celeron55/ipdm56/ipdmhw1.1/README.md

iPDM56 v1.1
===========

iPDM56 v1.1 fixing the board
----------------------------

There is one bug on the v1.1 board. This is what you need to do to get it
working:
- Replace R97 with a 1k resistor. Originally it is a 10k resistor. To save some
  effort, you can solder the 1k resistor on top of the 10k resistor, putting it
  in parallel. The package size is 0603. A through hole resistor will fit fine.
    - If this fix is not made, the CAN controllers will not work.

iPDM56 v1.1 flashing
--------------------

Bootloader:
- Install Arduino.
- Select Arduino Uno as the board in Arduino.
- Connect an ISP programmer like USBasp to the ISP header. GND is closer to board edge.
- Select the ISP programmer in Arduino's Tools menu.
- Use Arduino's "Burn bootloader" option in the Tools menu.

Uploading program:
- Select Arduino Uno as the board in Arduino.
- Plug in a USB 2.0 micro B cable to the USB connector, OR
- Cut your most hated USB cable in half and connect it to the 56-pin connector pins (according to the iPDM56 connector pinout):
	- 10: USB 5V  (red)
	- 12: USB D-  (white)
	- 14: USB D+  (green)
	- 16: USB GND (black)
