celeron55/ipdm56/ipdmhw1.0/flashing/iPDM56_v1.0_flashing_065.jpg

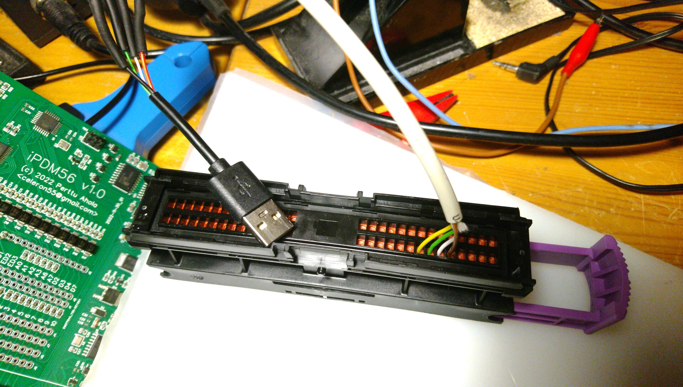
ipdmhw1.0/flashing/iPDM56_v1.0_flashing_065.jpg
