celeron55/ipdm56/ipdmhw1.0/iPDM56_v1.0_connector_photo_light.jpg

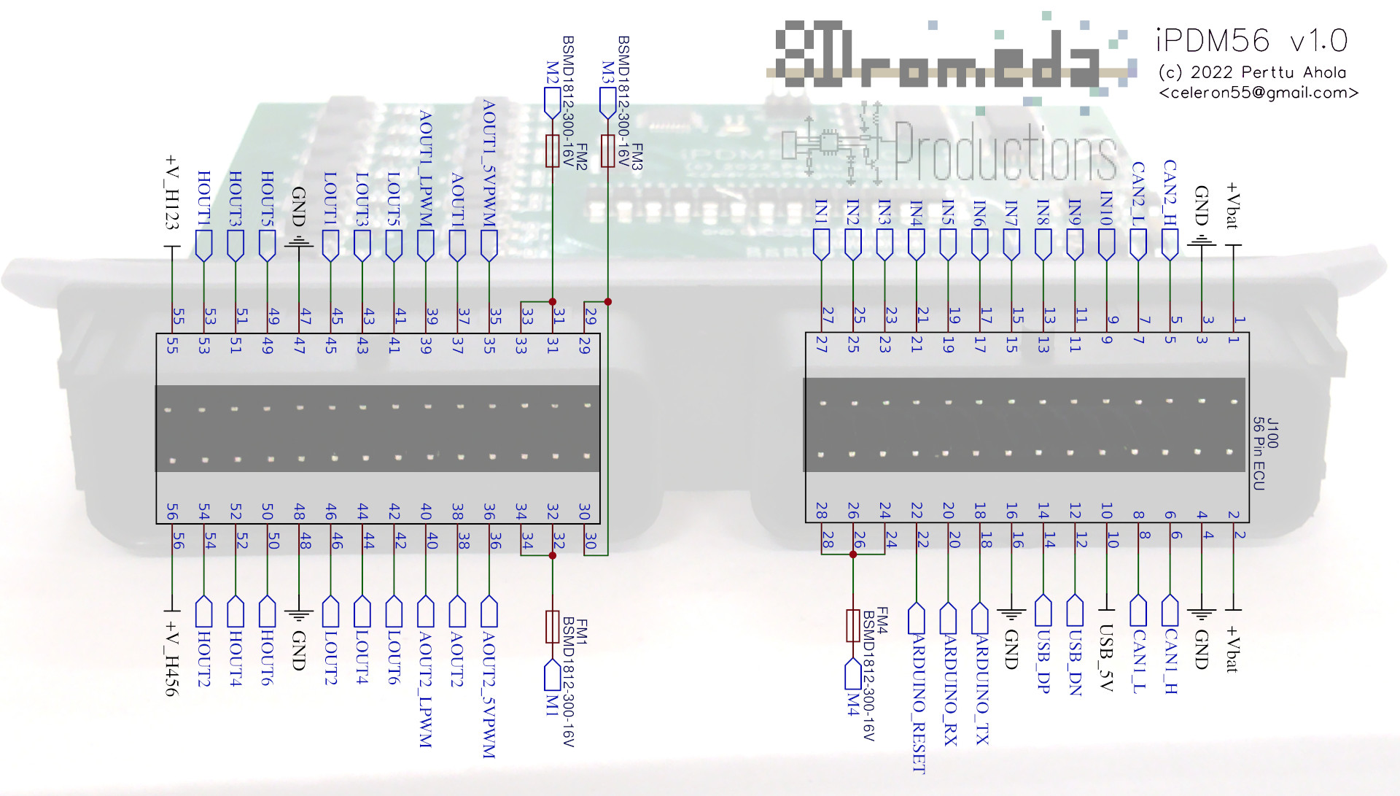
ipdmhw1.0/iPDM56_v1.0_connector_photo_light.jpg
