celeron55/ipdm56/ipdmhw1.1/iPDM56_v1.1_connector_photo_light.jpg

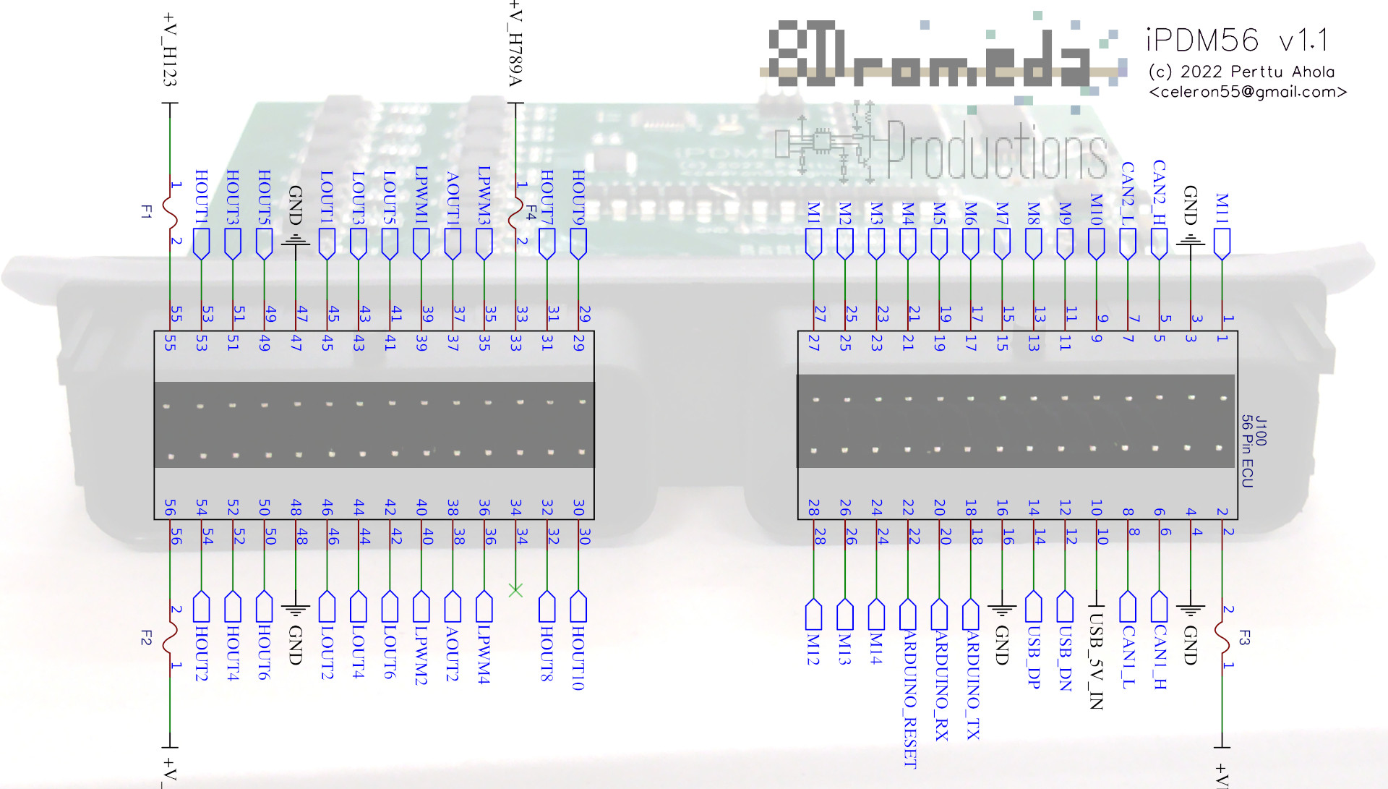
ipdmhw1.1/iPDM56_v1.1_connector_photo_light.jpg
