celeron55/ipdm56/ipdmhw1.1/ipdm56_v1.1_pcb_layers.png

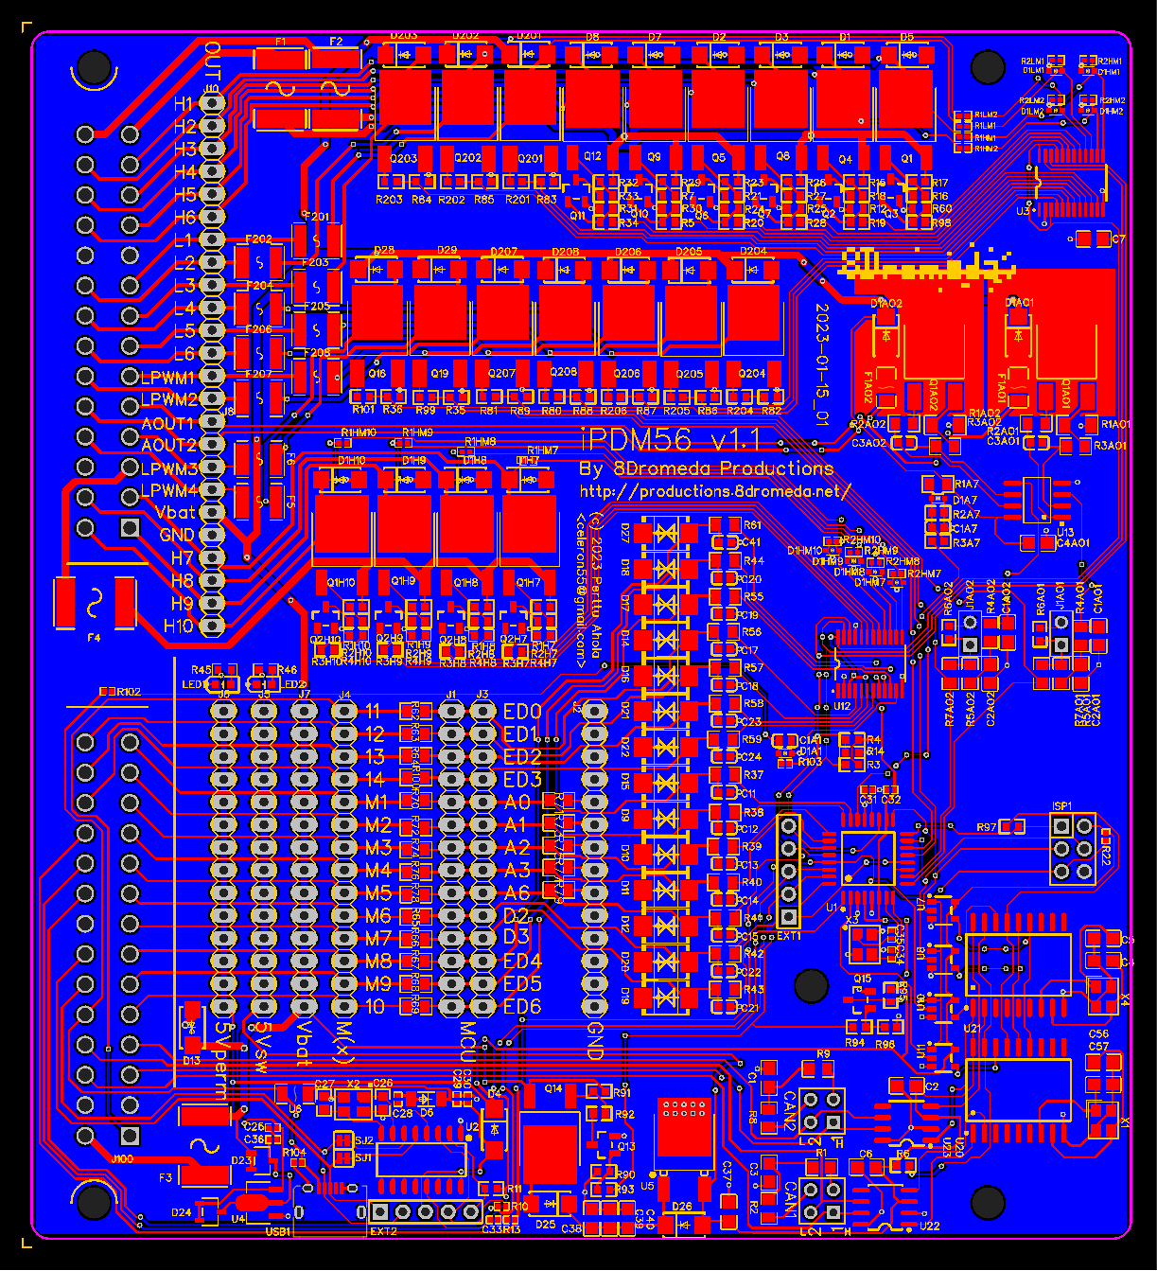
ipdmhw1.1/ipdm56_v1.1_pcb_layers.png
