celeron55/ipdm56/ipdmhw1.1/iPDM56_v1.1_PCB_render_backside.png

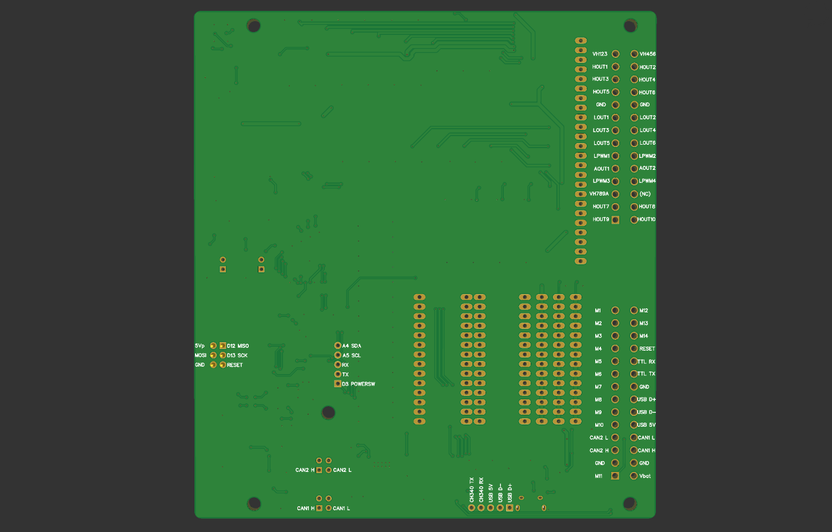
ipdmhw1.1/iPDM56_v1.1_PCB_render_backside.png
