celeron55/ipdm56/ipdmhw2.0/iPDM56v2.0_connector_pinout_light_upright.png

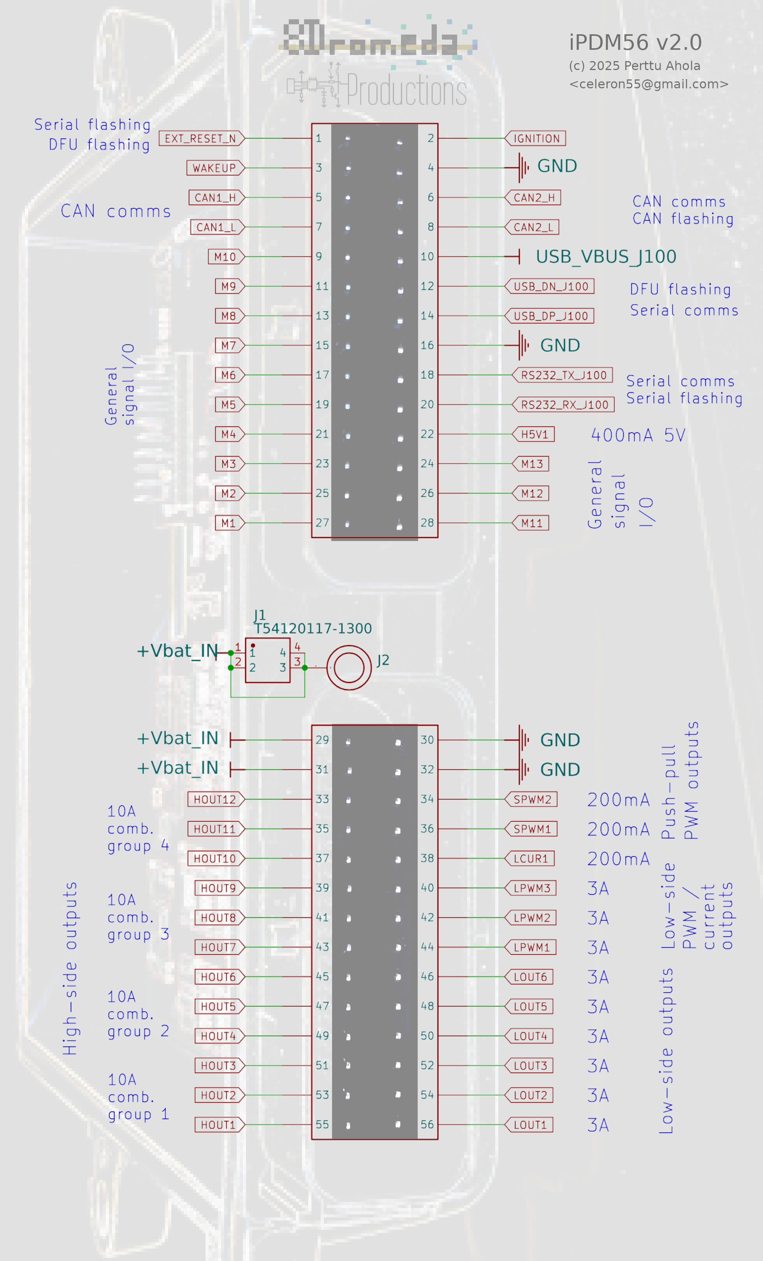
ipdmhw2.0/iPDM56v2.0_connector_pinout_light_upright.png
