celeron55/ipdm56/ipdmhw2.0/iPDM56v2.0_photo_in_enclosure.jpg

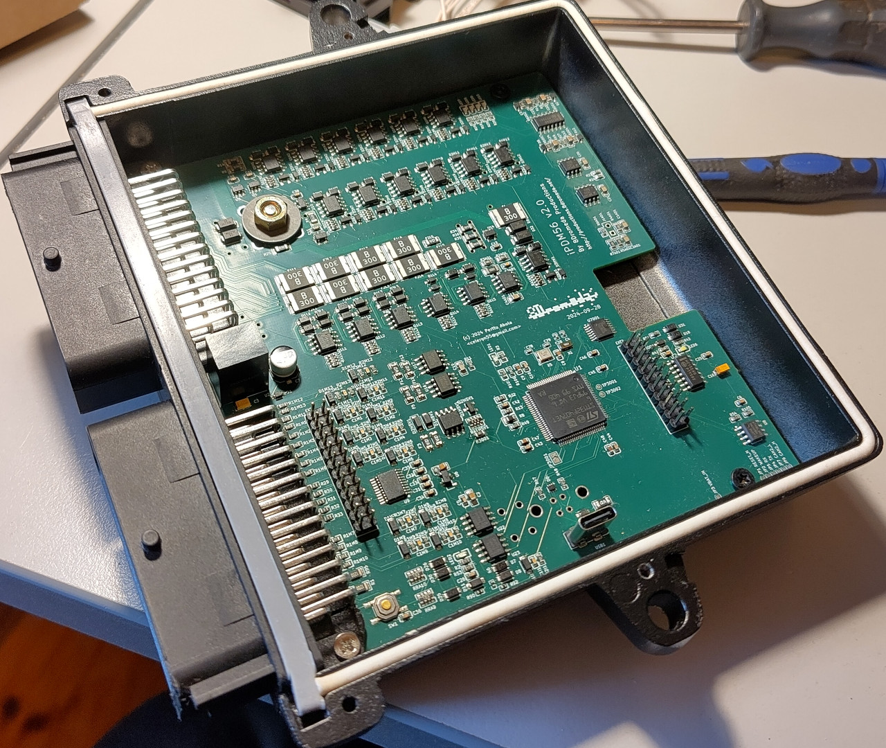
ipdmhw2.0/iPDM56v2.0_photo_in_enclosure.jpg
