celeron55/ipdm56/ipdmhw2.0/ipdmhw2.0_pcb_render_back.png

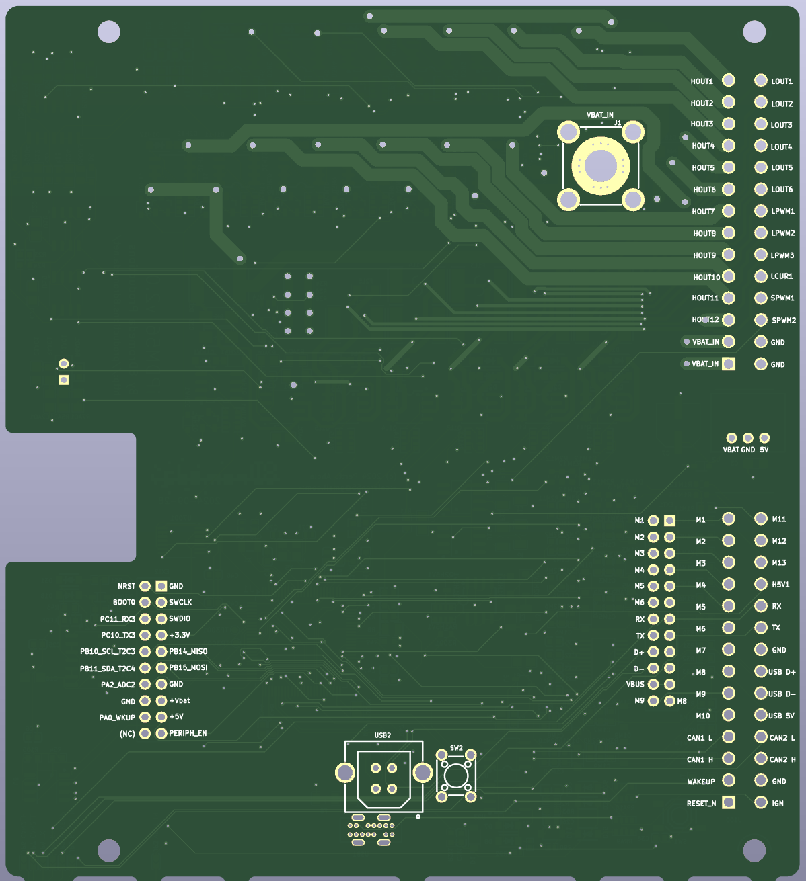
ipdmhw2.0/ipdmhw2.0_pcb_render_back.png
