celeron55/ipdm56/ipdmhw1.0/iPDM56_v1.0_PCB_2022-11-30_render2_components.png

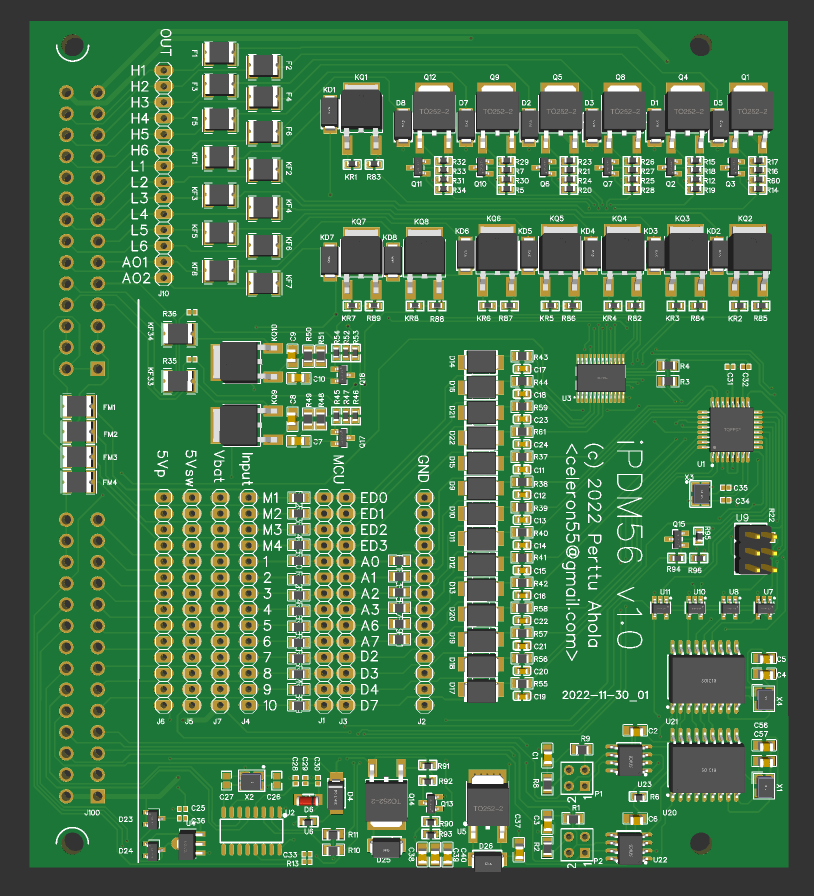
ipdmhw1.0/iPDM56_v1.0_PCB_2022-11-30_render2_components.png
