celeron55/ipdm56/ipdmhw1.0/iPDM56_v1.0_PCB_render3_components_3D.png

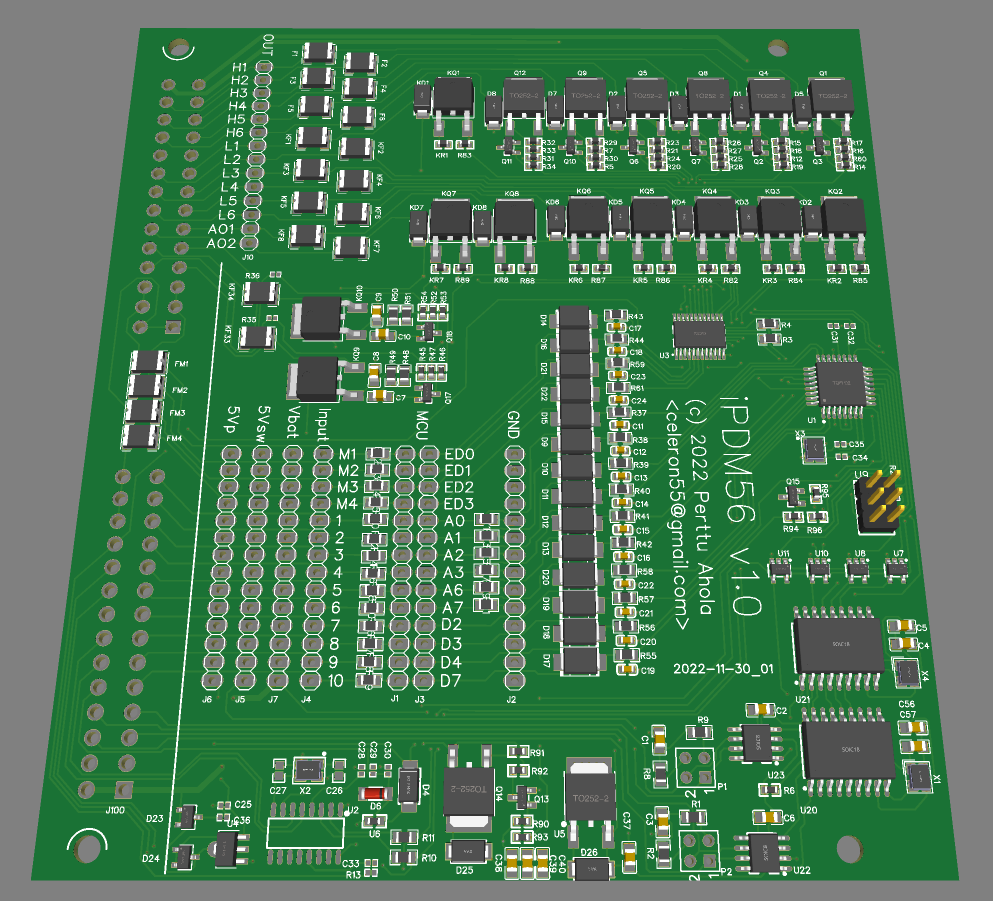
ipdmhw1.0/iPDM56_v1.0_PCB_render3_components_3D.png
