celeron55/ipdm56/ipdmhw1.1/iPDM56_v1.1_PCB_render_components2.png

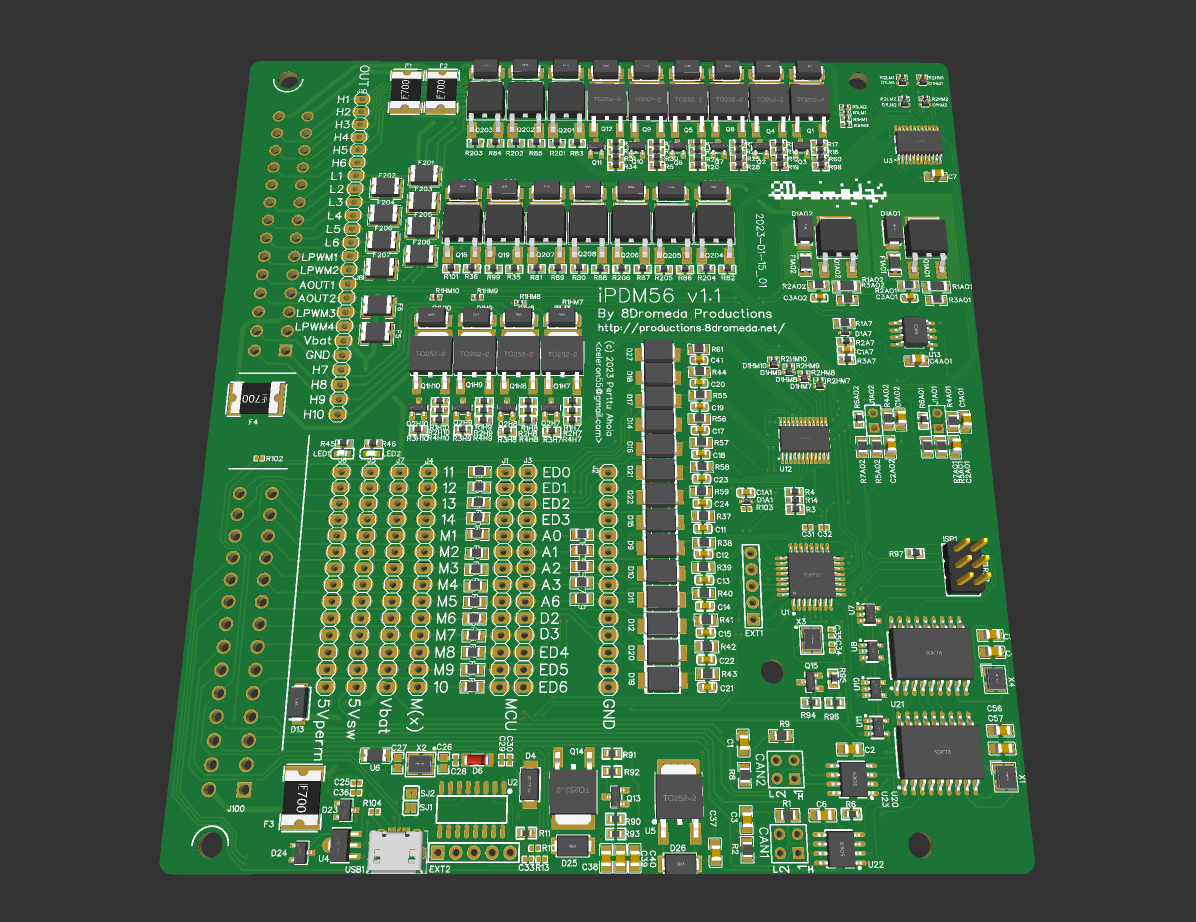
ipdmhw1.1/iPDM56_v1.1_PCB_render_components2.png
