celeron55/ipdm56/(threads)

Thread 1 (2023-01-17):

Remote connectivity for remote heating/cooling and possibly checking car status

celeron55, 2023-01-17:
LoRa was suggested. It would make a lot of sense as it's low power, long range and cheap.

Really just need to pick a module and figure out what the recommended connection to the ipdm hardware would be, and then implement software support.

celeron55, 2023-01-17:
Pete9008 talks about the LoRa transceivers here. Lots of very useful info: https://openinverter.org/forum/viewtopic.php?p=50404#p50404
