celeron55/ipdm56/ipdmhw1.1/ipdm56_v1.1_schematic.pdf

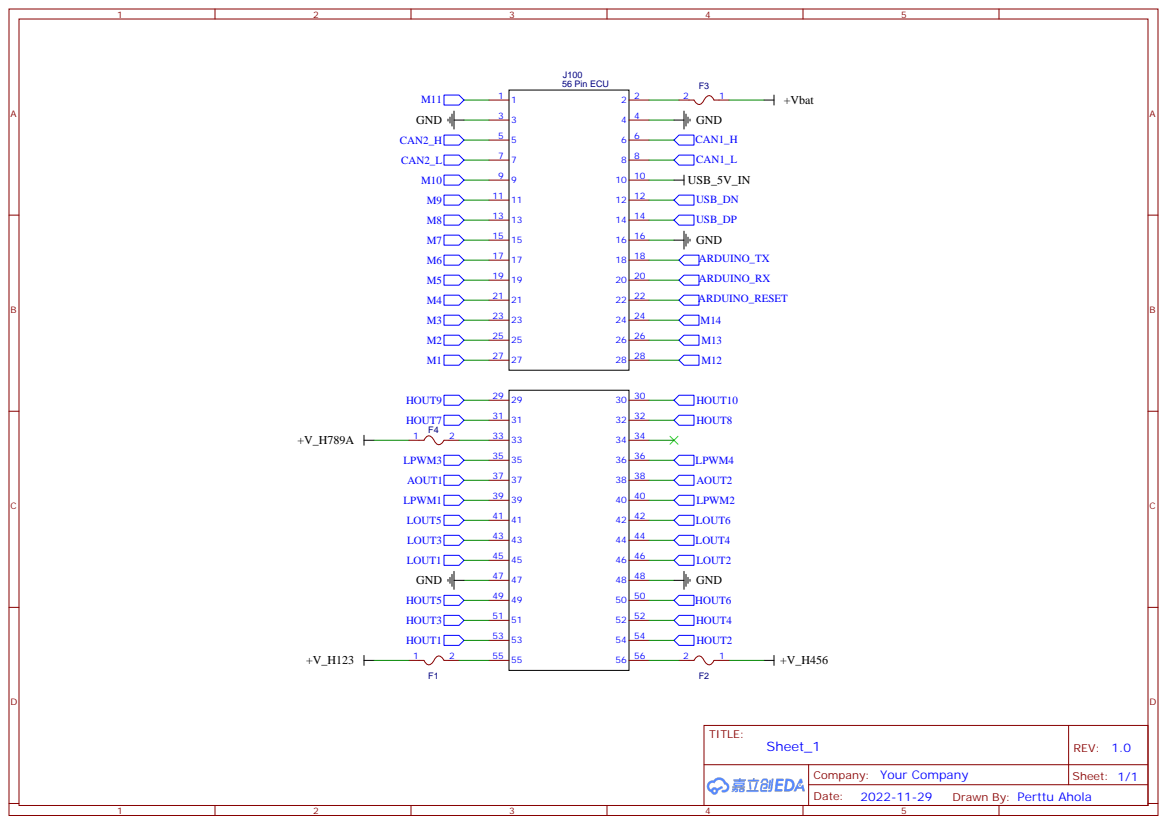
[picture p34: page 1]

Drawn By: Perttu Ahola

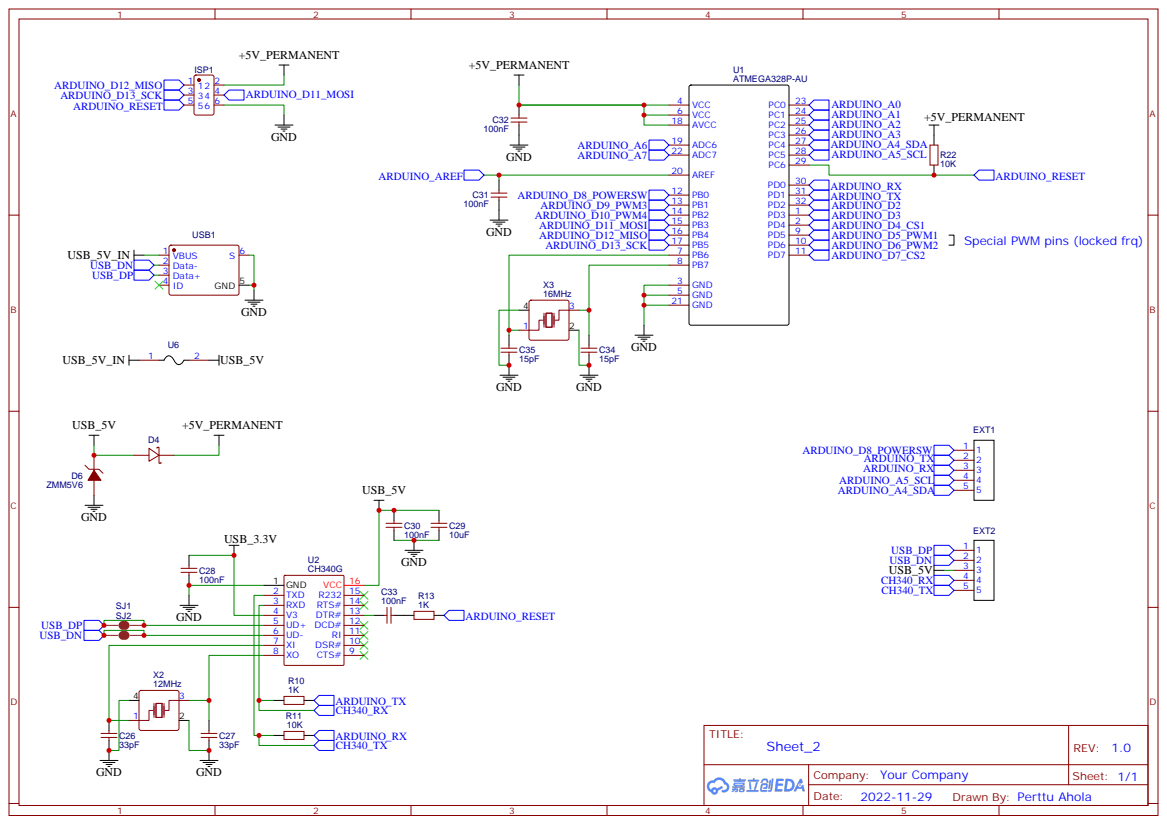
[picture p35: page 2]

DSR# 10 RI 11 DCD# 12 DTR# 13 RTS# 14 R232 15 VCC 16

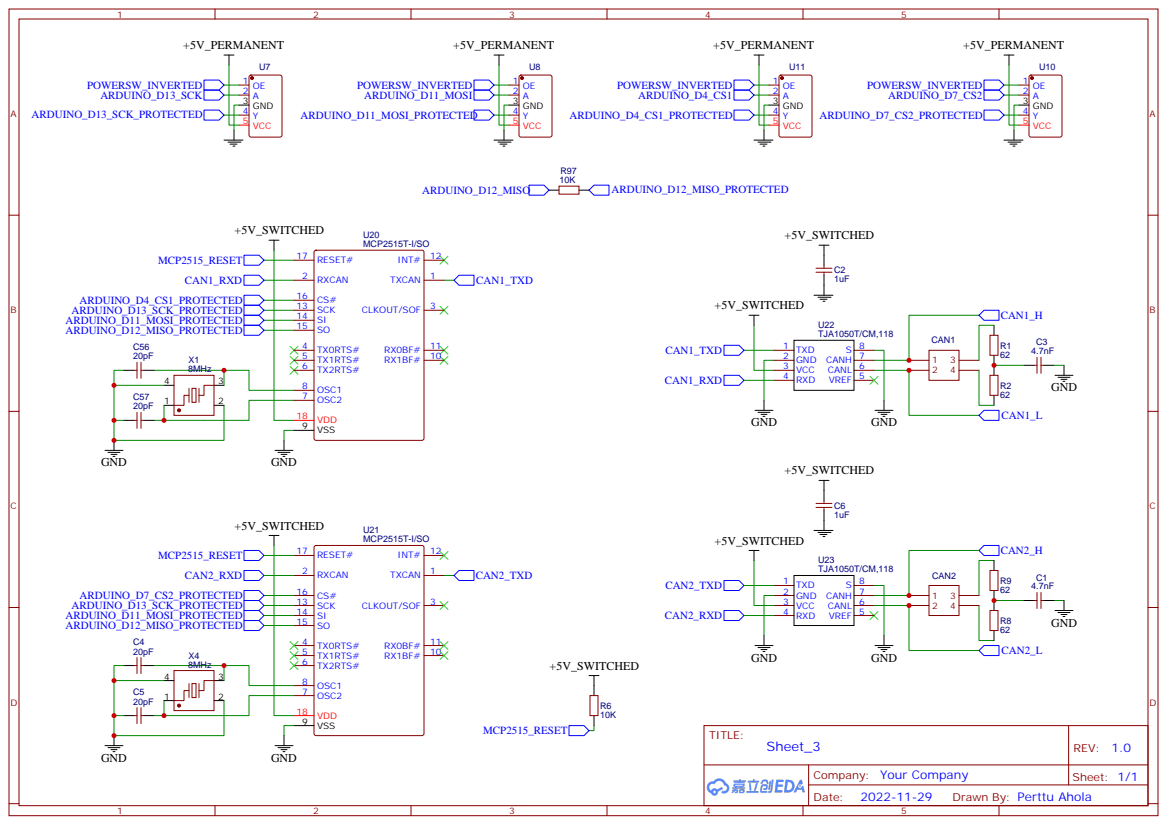
[picture p36: page 3]

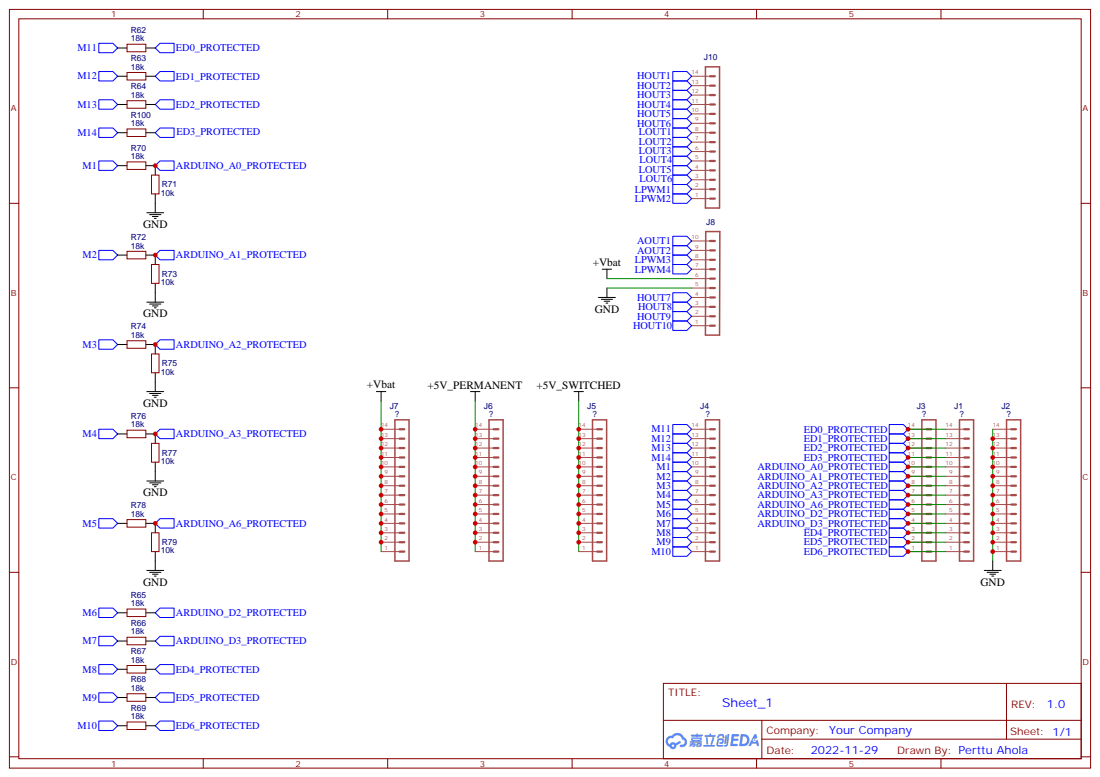
[picture p37: page 4]

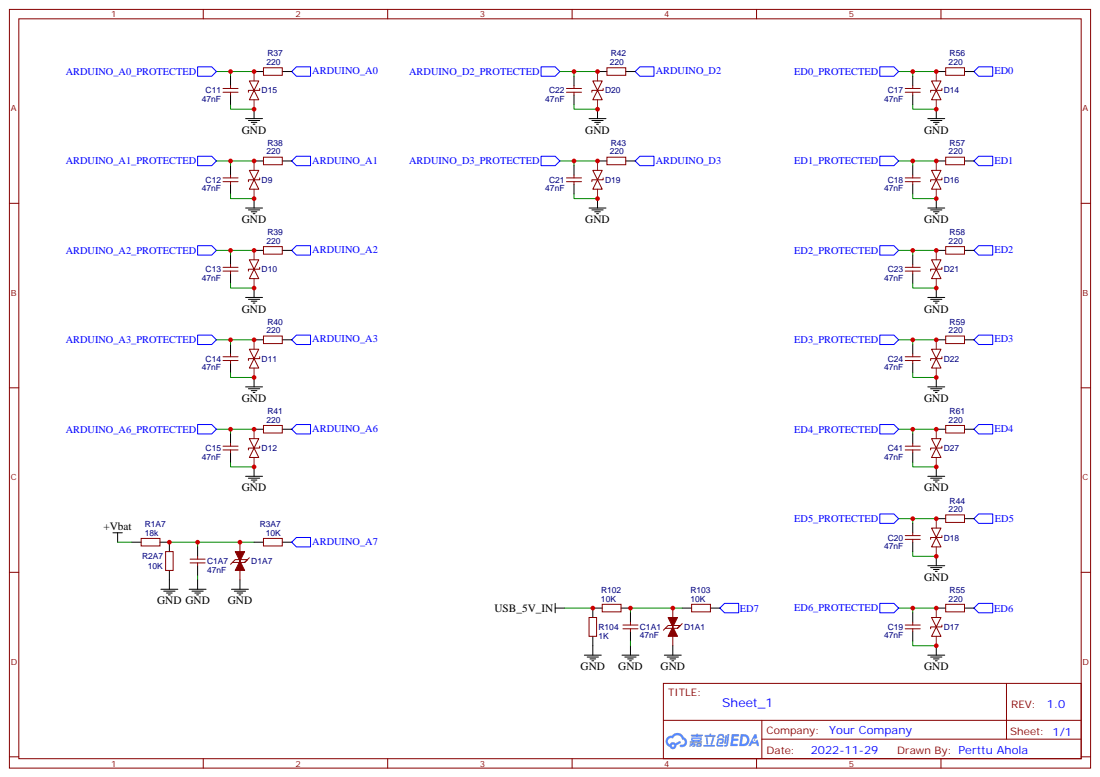
[picture p38: page 5]

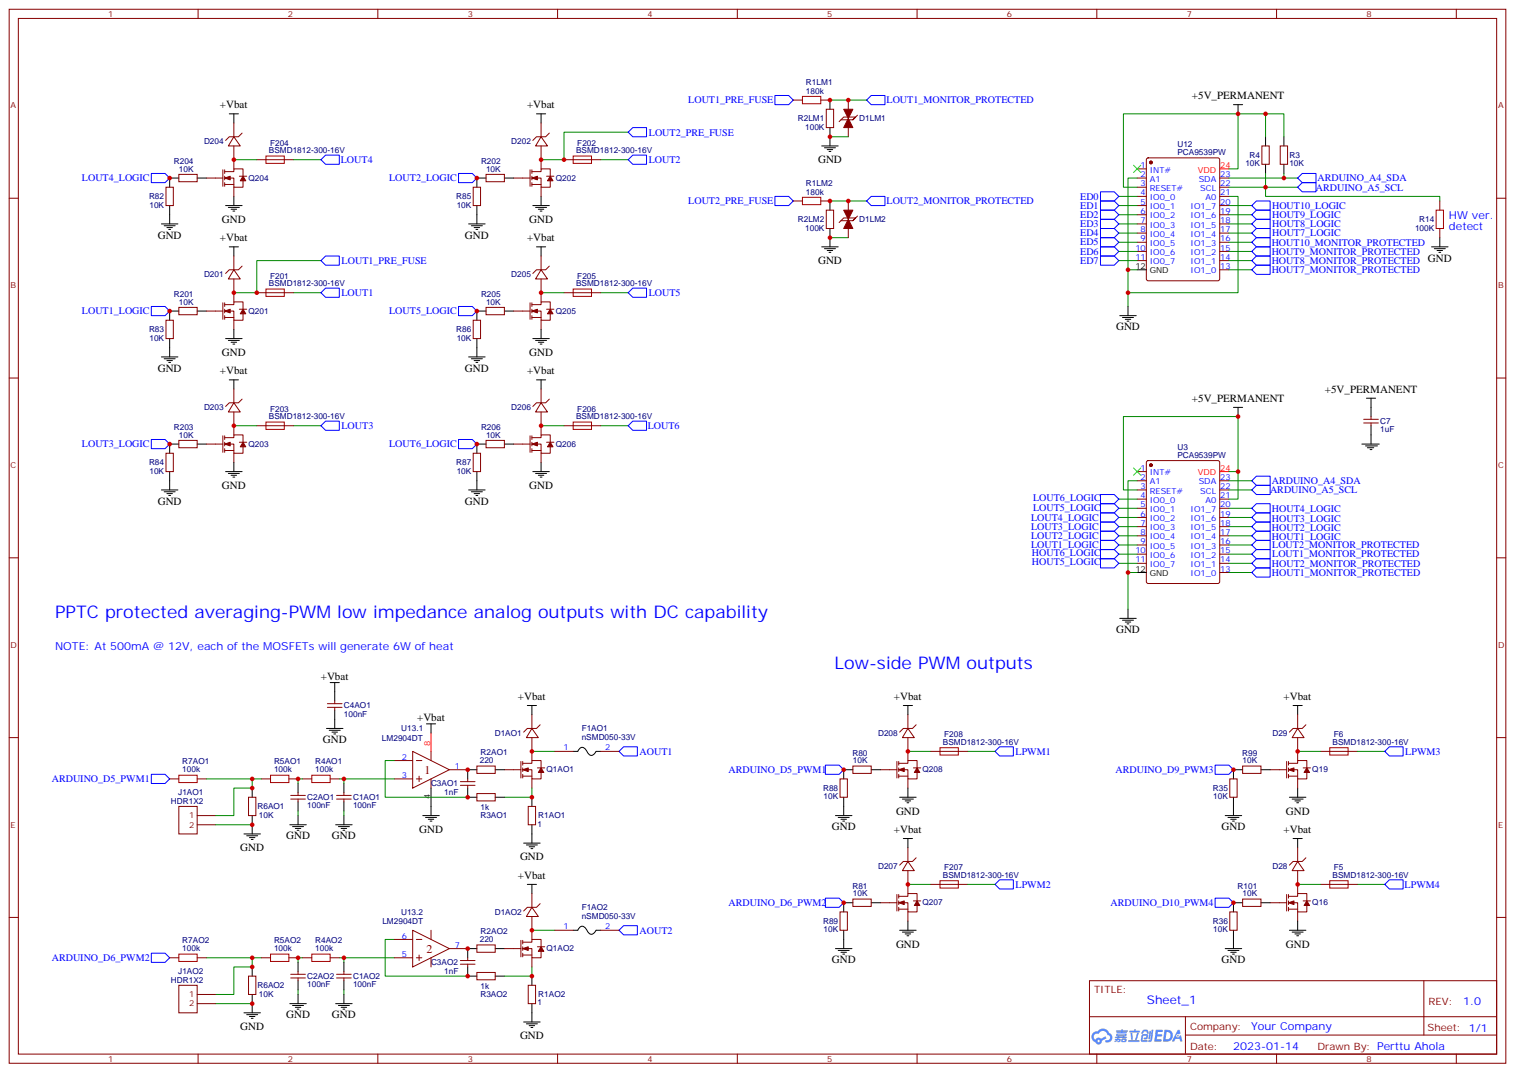
[picture p39: page 6]

PPTC protected averaging-PWM low impedance analog outputs with DC capability

NOTE: At 500mA @ 12V, each of the MOSFETs will generate 6W of heat

Low-side PWM outputs

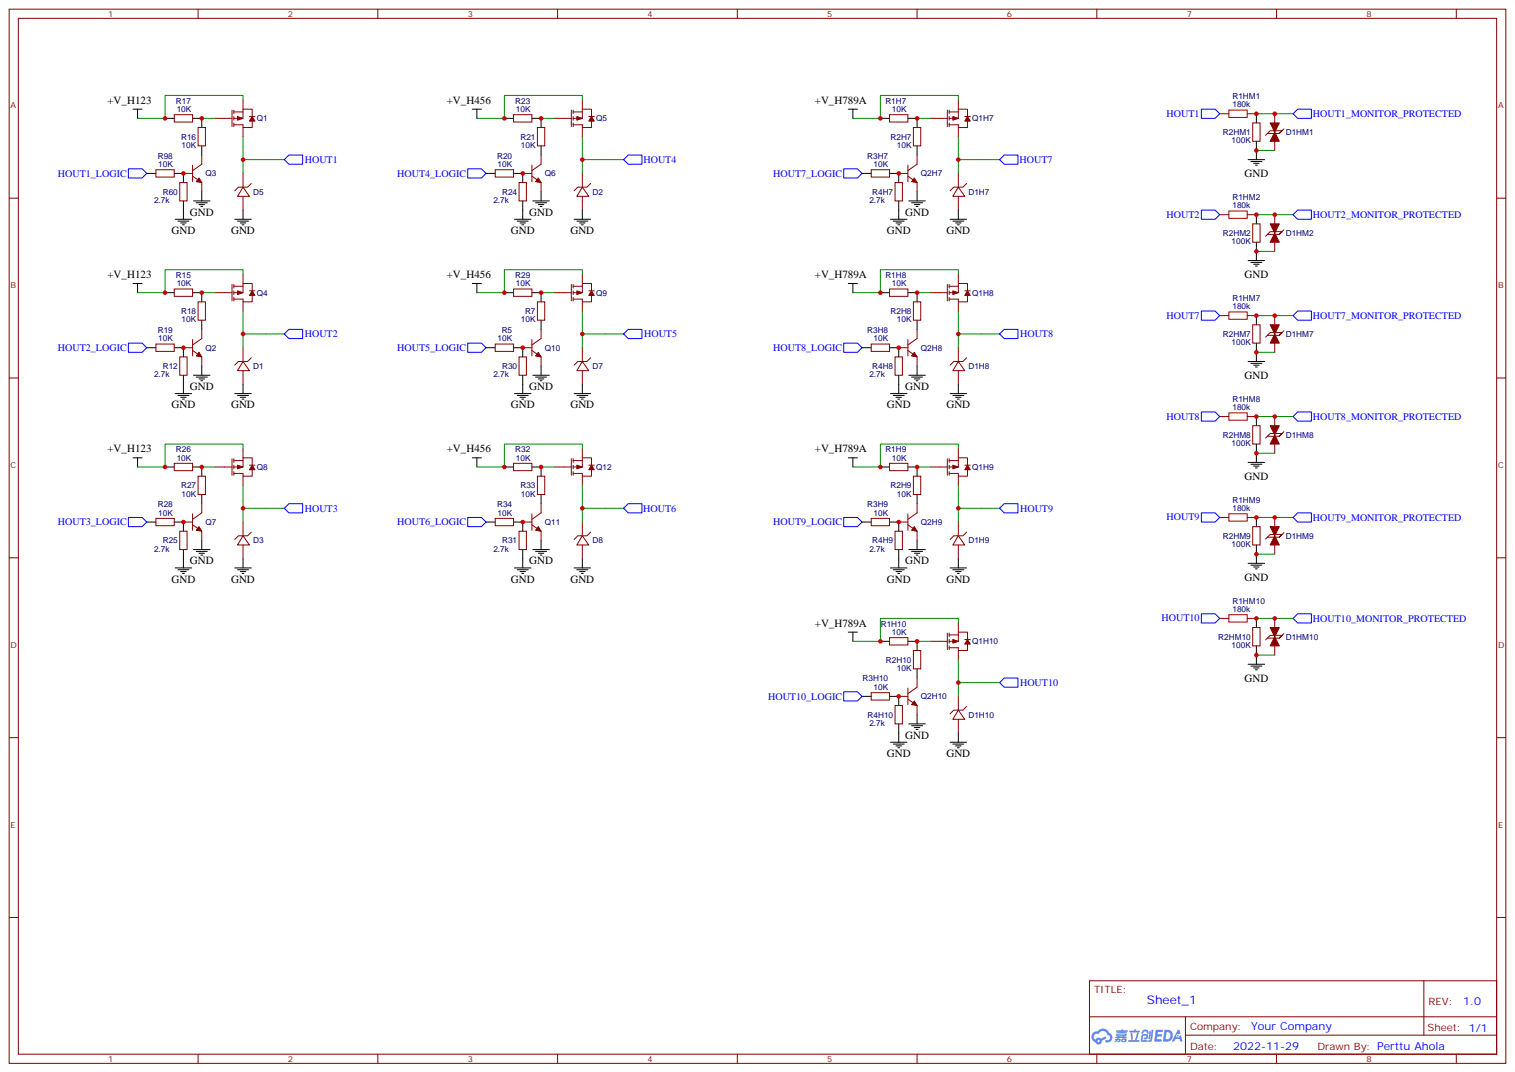
[picture p40: page 7]

Permanent 5V regulator (100mA) | Power switch inversion logic

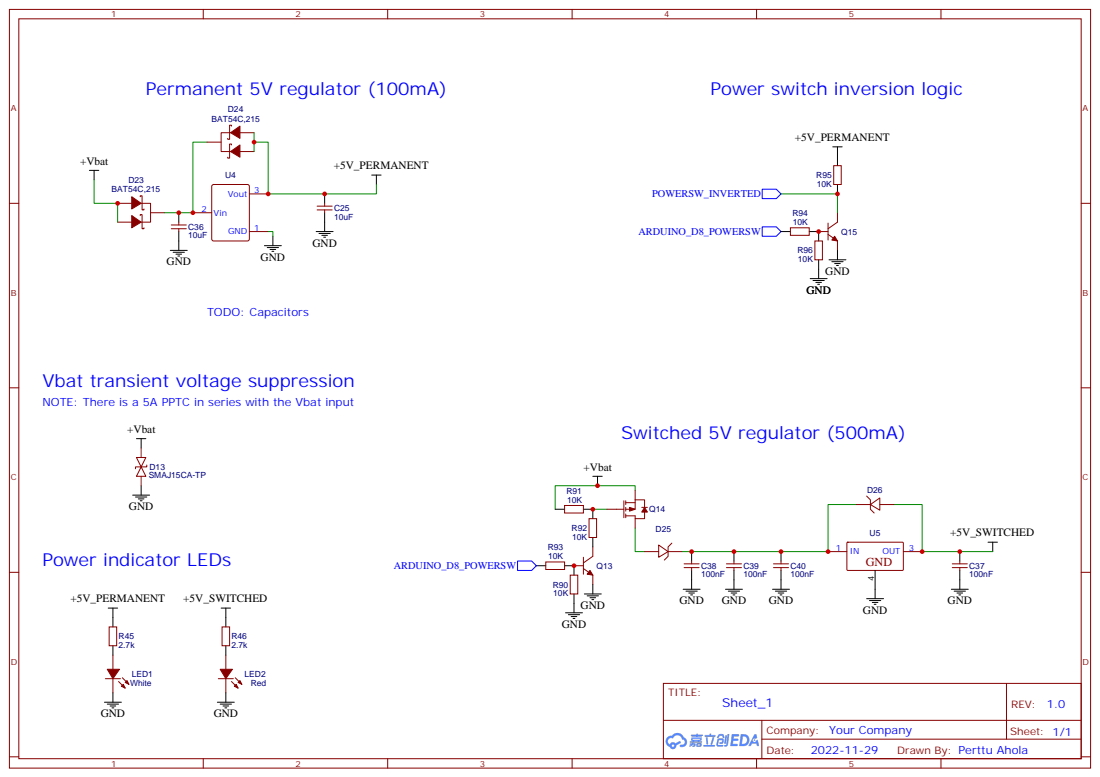
[picture p41: page 8]

Vbat transient voltage suppression
NOTE: There is a 5A PPTC in series with the Vbat input
