celeron55/ipdm56/ipdmhw1.0/iPDM56_v1.0_schematic_2022-11-30_01.pdf

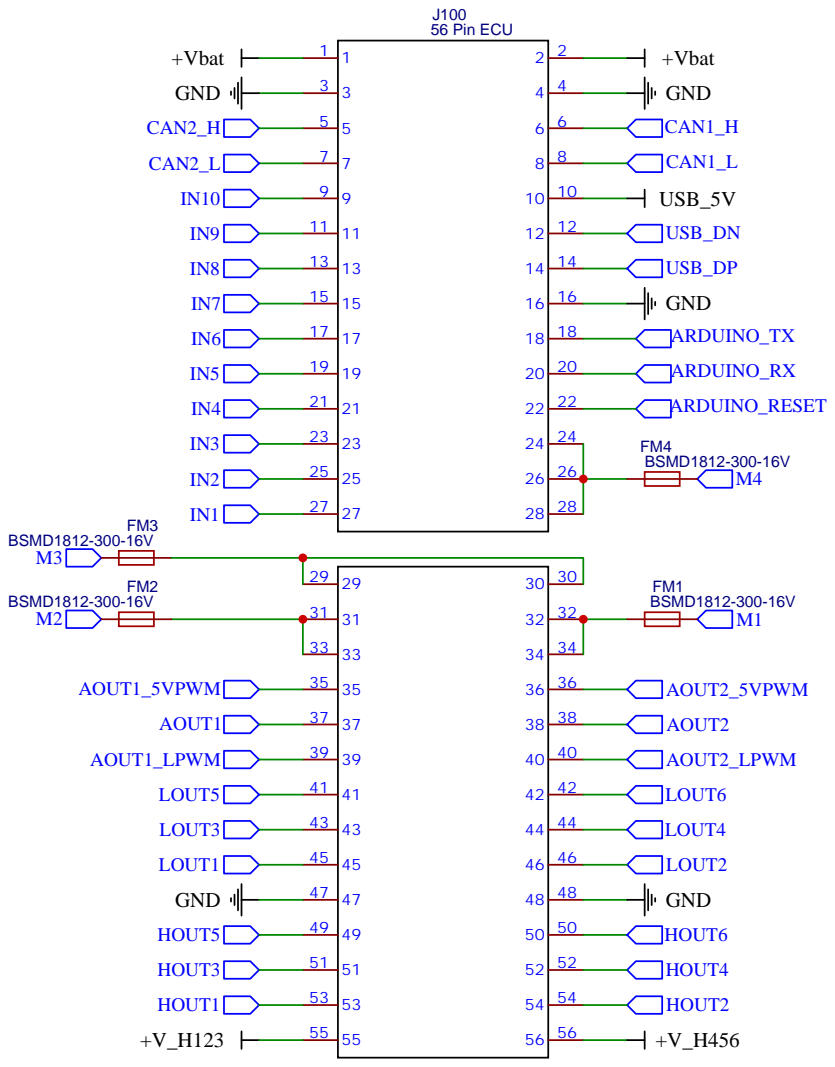
[picture p42: page 1]

Drawn By: Perttu Ahola

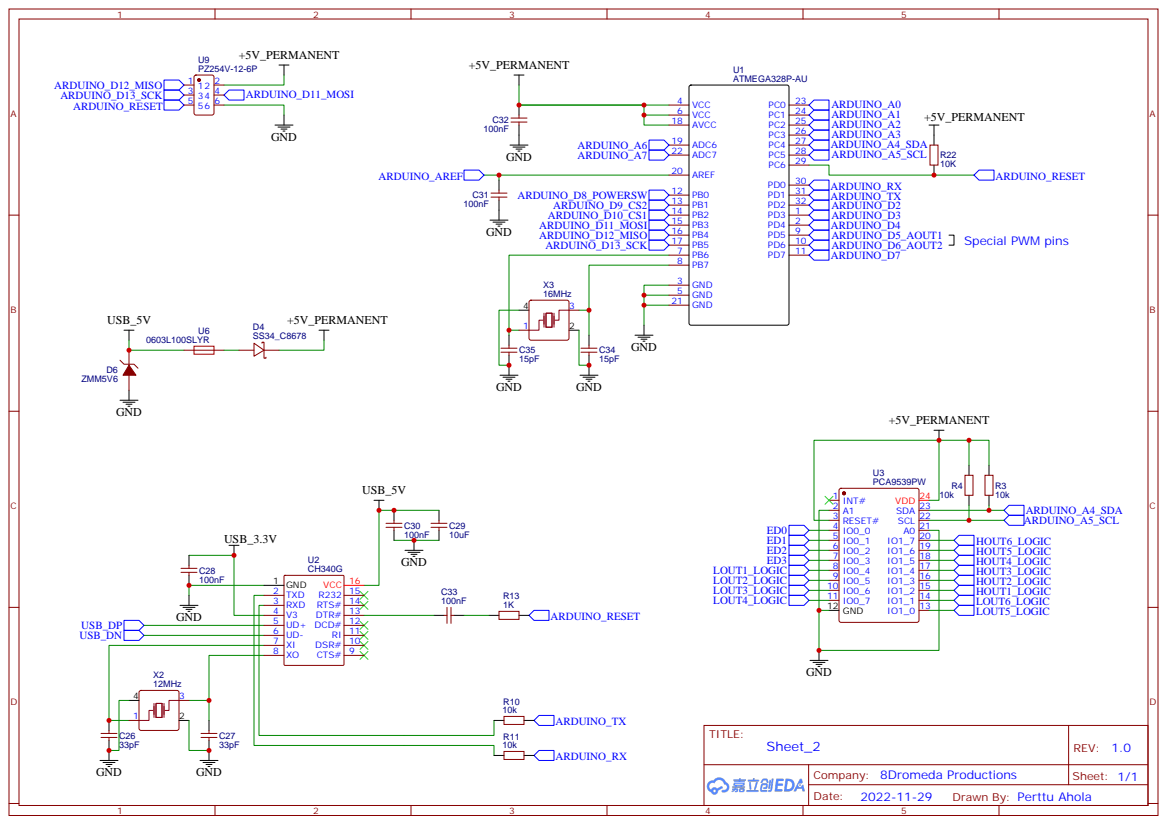
[picture p43: page 2]

DSR# 10 RI 11 DCD# 12 DTR# 13 RTS# 14 R232 15 VCC 16

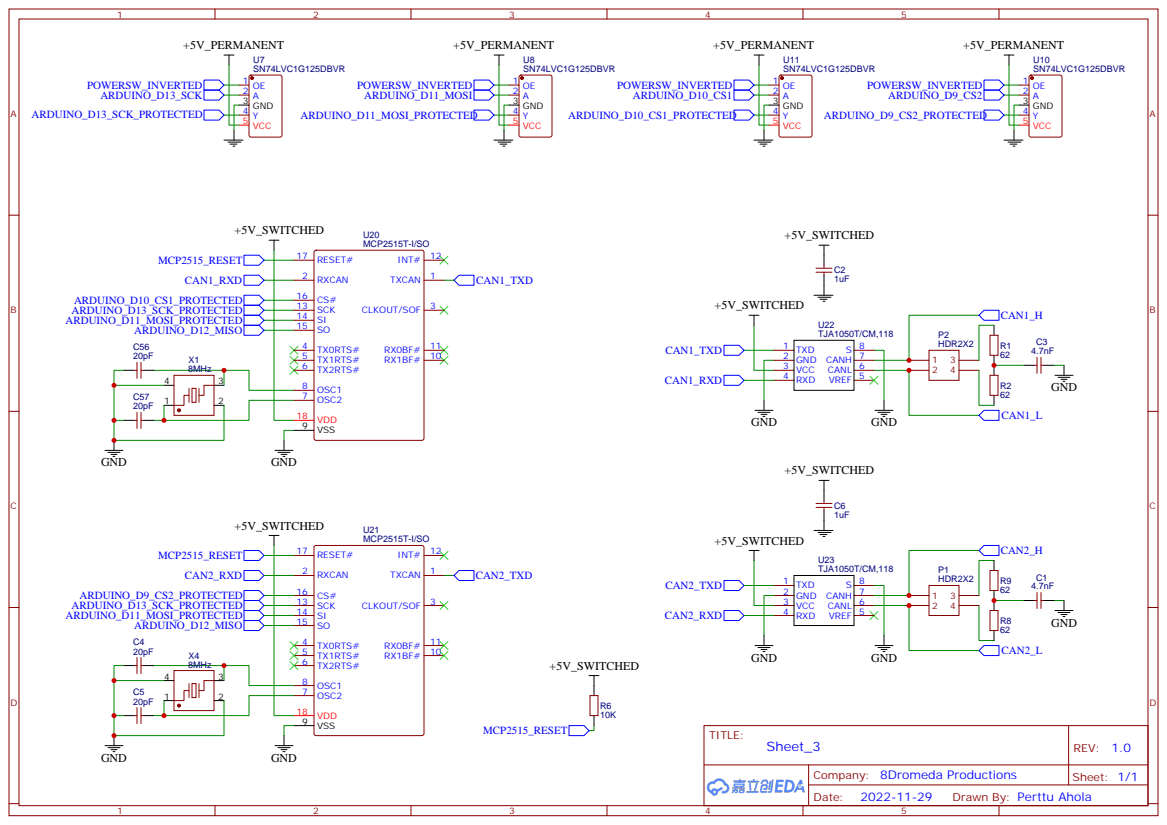
[picture p44: page 3]

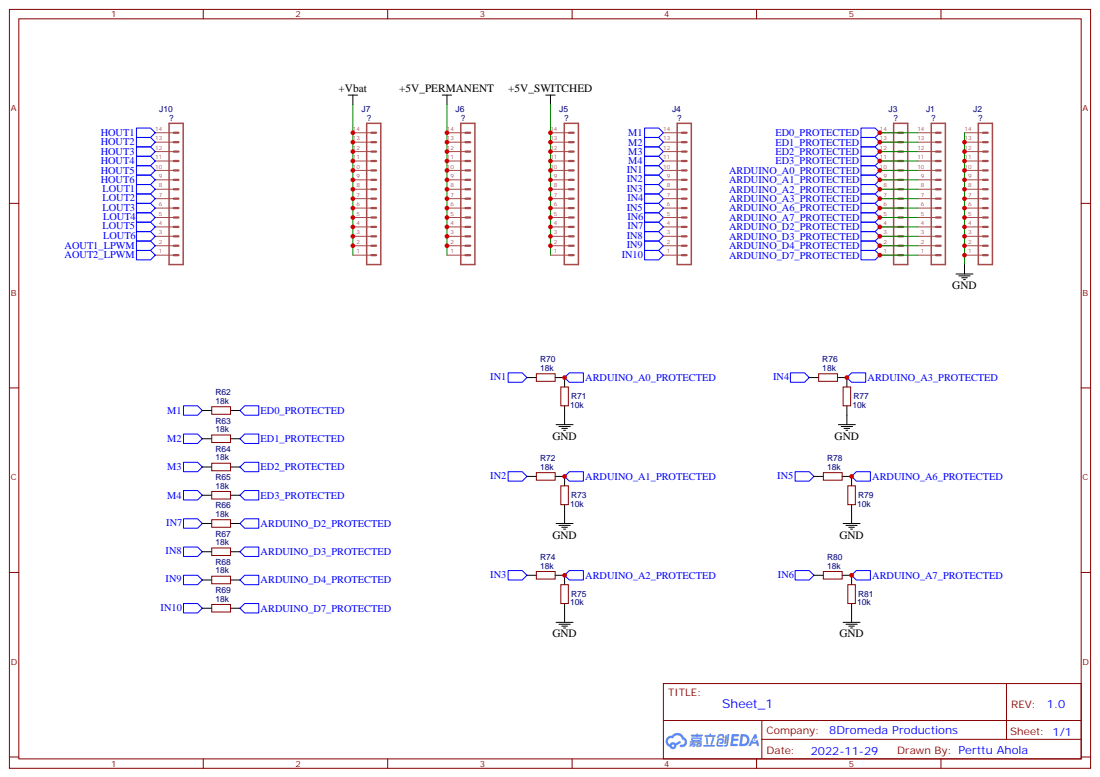
[picture p45: page 4]

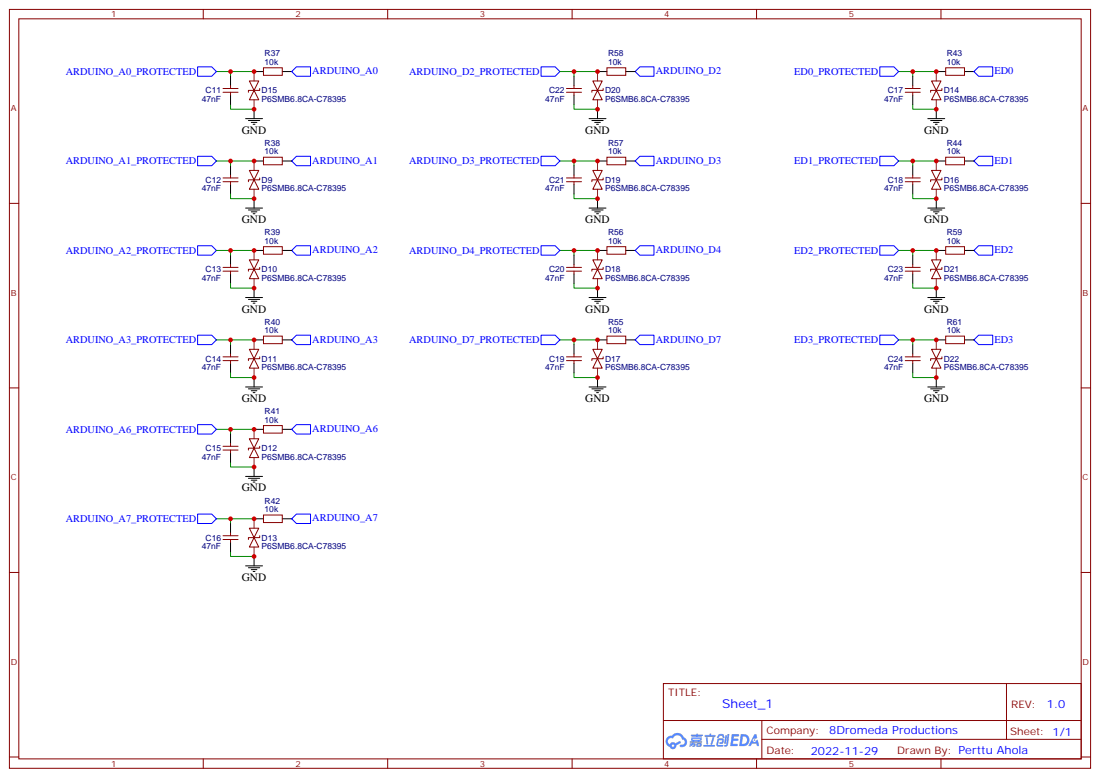
[picture p46: page 5]

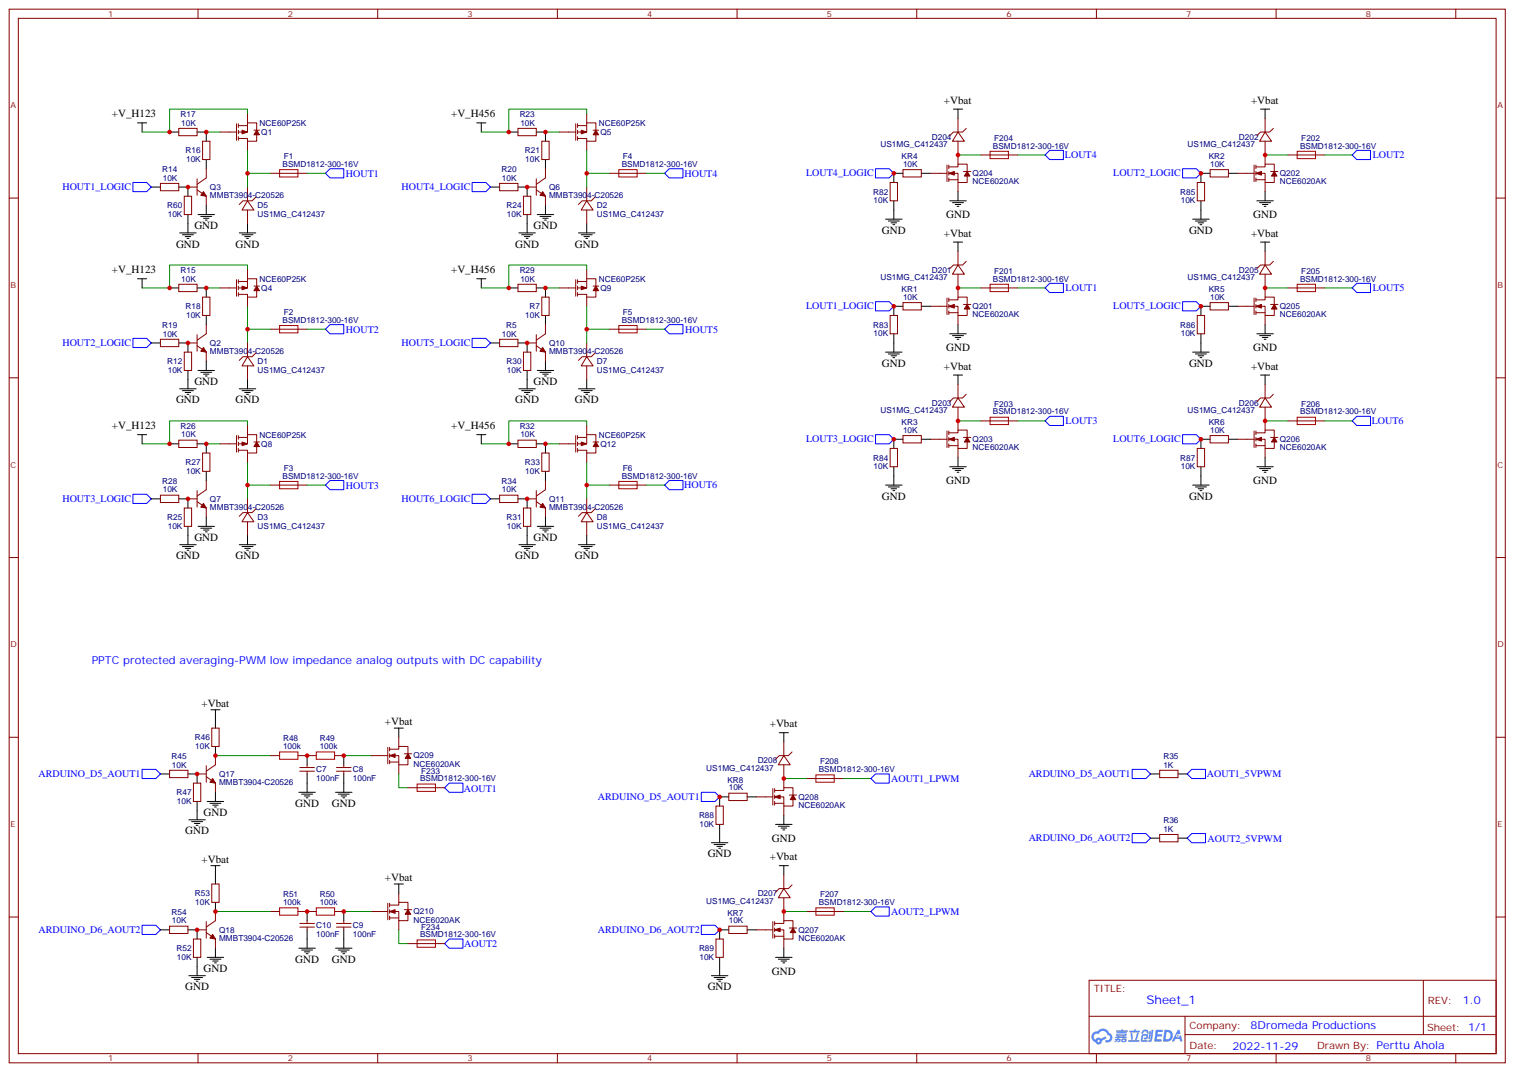
[picture p47: page 6]

PPTC protected averaging-PWM low impedance analog outputs with DC capability

Permanent 5V regulator (100mA) | Power switch inversion logic

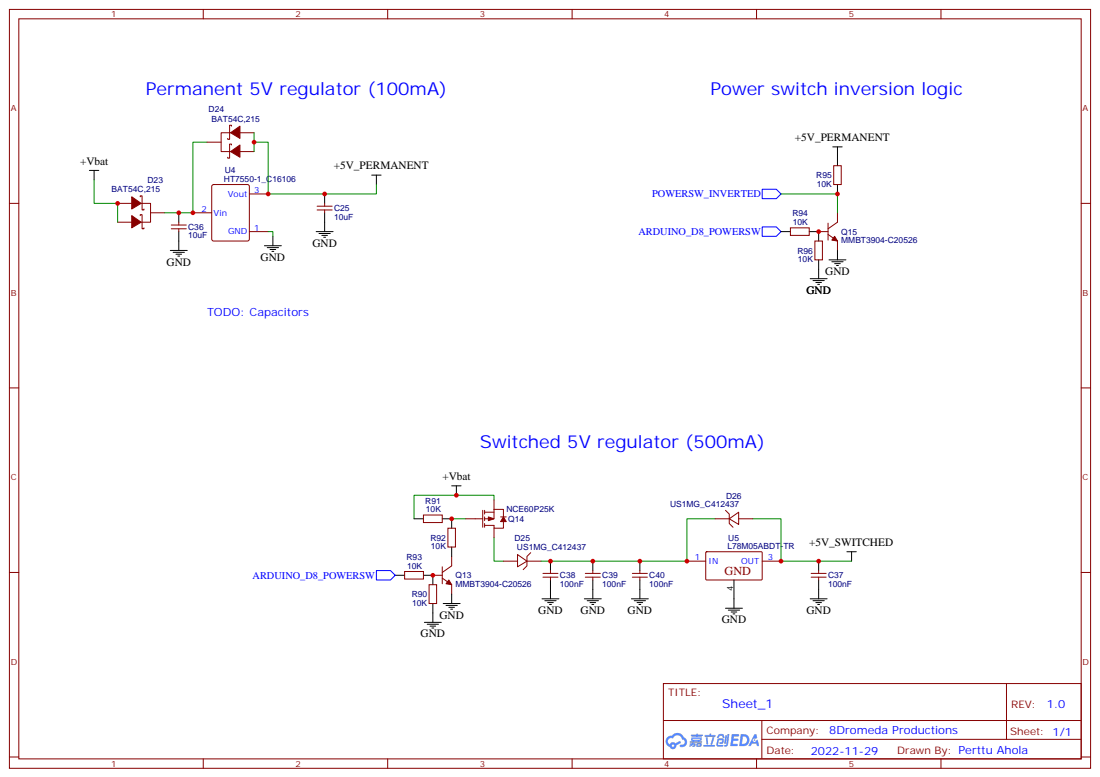
[picture p48: page 7]
