celeron55/ipdm56/ipdmsw/src/params.h

/*
ipdm - iPDM56 firmware
Copyright (c) 2022 Perttu "celeron55" Ahola

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
You should have received a copy of the GNU General Public License
along with this program.  If not, see <https://www.gnu.org/licenses/>.
*/

// This file (src/params.h) implements a global parameter database according to
// user application's definitions in param_def.h

#pragma once
#include "ipdm_time.h"
#include <stdint.h>
#include <Stream.h>

struct Modules {
	#define MODULE_DEF(name, timeout_ms) \
		struct { \
			uint8_t timeout_counter = 254; /* incremented at 100ms interval, 255=dead */ \
			void timeout_reset(){ \
				timeout_counter = 0; \
			} \
			void run_timeout(Stream &stream){ \
				if((timeout_ms) == 0 || timeout_counter == 255) return; \
				timeout_counter++; \
				if(timeout_counter > ((timeout_ms) / 100)){ \
					timeout_counter = 255; \
					stream.println(F("-!- " #name " timed out")); \
				} \
			} \
			bool alive(){ \
				return timeout_counter != 255; \
			} \
		} name;
	#define PARAM_DEF(module_name, name, type, default_value, report_hysteresis)
	#include "../param_def.h" // Parameters defined by user application
	#undef PARAM_DEF
	#undef MODULE_DEF

	void run_timeouts(Stream &stream);
};

extern Modules modules;

struct Params {
	#define MODULE_DEF(name, timeout_ms)
	#define PARAM_DEF(module_name, name, type, default_value, report_hysteresis) \
		struct { \
			volatile type value = (default_value); \
			volatile const type& set(const type &new_value){ \
				value = new_value; \
				/* This could be enabled to have automatic reset on set() */ \
				/*modules.module_name.timeout_counter = 0;*/ \
				return value; \
			} \
			void clear_timed_out_value(){ \
				if(modules.module_name.timeout_counter == 255) \
					value = (default_value); \
			} \
			bool alive(){ \
				return modules.module_name.timeout_counter != 255; \
			} \
			void report_value(Stream &stream){ \
				::ipdm::util_print_timestamp(stream); \
				stream.print(F("-!- " #module_name "_" #name " = ")); \
				stream.println(value); \
			} \
		} module_name##_##name;
	#include "../param_def.h" // Parameters defined by user application
	#undef PARAM_DEF
	#undef MODULE_DEF

	// Shall be called at 100ms interval
	void clear_timed_out_values();

	void report_if_changed(Stream &stream);

	void report_all_values(Stream &stream);
};

extern Params params;
