celeron55/ipdm56/(commit log)

2022-12-13 ipdm56_example_1: Monitor Vbat and re-initialize CANbus when 5Vsw is actually expected to be powered up
2022-12-18 ipdm_library: Improved switched_5v_ok reporting
2022-12-26 ipdm_util.h: Fix and add some stuff
    [ipdm_util.h]
2023-01-01 ipdmhw1.0/README.md: Document USB wire colors
2023-01-01 ipdmsw: PWM/analog output example
2023-01-08 ipdmsw: Rename maximum_power_save_mode -> power_save_delay
2023-03-13 ipdmhw1.1: Add note about fixing the board (R97 10k -> 1k)
2023-03-18 Move board documentation from doc to the upper level
2023-04-06 Mention fast charging as a use case for CAN and 12V I/O based protocols
2023-04-17 ipdmsw: Fix module timeout_ms=0 behavior
    [params.h]
2023-04-21 ipdmsw: Remove some CAN debug prints
2023-04-21 ipdmsw: Improve power_save_delay() a bit. Not perfect yet but useful
2023-04-24 ipdmsw/src/ipdm_io: Fix VUSB_PIN on hw1.1
    [ipdm_io.cpp, ipdm_io.h]
2024-01-13 ipdmsw/src/ipdm_library.h: Add comment about power_save_delay()
2024-02-08 ipdmsw: Use progmem (F()) strings in print and println calls
2024-02-11 ipdmsw: Drop longtime() and instead increment Arduino's internal timer0_millis
2025-04-13 ipdmhw2.0/README.md: Update PWMOUT problem description and add a note about C7 interference with cover
2025-05-10 ipdmrust: Fix BOOT0 control and I2C SCL pin
    [main.rs]
2025-05-10 Print main contactor state every 15 seconds for initial debugging
2025-05-10 ipdmrust: Print output status changes
2025-05-10 ipdmrust: Disable BatteryPump as it seems to cause issues with DcdcEnable
    [lib.rs]
2025-05-10 ipdmrust: Measure vbat from the correct ADC pin
    [main.rs]
2025-05-10 ipdmrust: Correct Group*OC polarity
    [main.rs]
2025-05-11 ipdmhw2.0/README.md: Document HOUT current limiters
2025-05-11 Revert "ipdmrust: Disable BatteryPump as it seems to cause issues with DcdcEnable"
    This reverts commit 4eabb4416d402e75924204f2792b3f9f3fd80326.
    [lib.rs]
2025-05-11 ipdmrust: Outlander heater control
2025-05-12 ipdmrust: Implement PWM outputs LCUR1, SPWM1 and SPWM2
2025-05-12 ipdmrust: Fix can bit scaling
    [lib.rs]
2025-05-12 ipdmrust: Implement PWM outputs LPWM2 and LPWM3
2025-05-12 ipdmrust: Use Foccci's CP PWM value
2025-05-12 ipdmrust: AC charging WIP
2025-05-12 README.md: The raw command for UART firmware update
2025-05-12 ipdmrust: Hack around CAN transmit problem
    [main.rs]
2025-05-12 ipdmrust: Try to AC charge using the Outlander OBC
2025-05-12 ipdmrust: Fix Outlander OBC voltage setpoint
    [lib.rs]
2025-05-12 ipdmrust: AC charging works using ignition key to close main contactor
2025-05-12 ipdmrust: Don't activate solenoids when main contactor is open, as then the DC/DC isn't providing 12V
2025-05-12 ipdmrust: Shut down system when charging finishes
2025-05-12 ipdmrust: Publish backwards compatible OBC DC current reading for old SIM900 unit which will still be in use for a short while
    [lib.rs]
2025-05-12 ipdmrust: Adjust charge competion voltage limits to match BMS defaults
2025-05-12 ipdmrust: Implement rebooting OBC on ignition off event like in EV-Omega
    [lib.rs]
2025-05-13 ipdmrust: Wake up for 30min every 24h to charge the 12V battery and send data, if SoC was seen to be above 10%
2025-05-13 ipdmrust: Set correct bit in 0x200 for request_inverter_disable
    [lib.rs]
2025-05-13 ipdmrust: Increase CAN RX buffer size to avoid losing frames in a busy bus
    [main.rs]
2025-05-13 ipdmrust: Reboot OBC/DCDC every 30 minutes if it's not DCDCing
    [lib.rs]
2025-05-13 ipdmrust: Set BMS charge completion voltage setting
2025-05-13 ipdmrust: Fix AC charging at low current
    [lib.rs]
2025-05-14 ipdmrust: Publish PcbT
2025-05-14 ipdmrust: Activate EVSE on DC charging PWM also, but keep Foccci and OBC out of AC charging state if DC charging
2025-05-15 ipdmhw2.0: Connector pinout and board images
2025-05-16 ipdmrust: Add most of the remaining analog and digital inputs, at least all the externally visible ones, including current measurements
2025-05-16 ipdmrust: Use some filtering on current measurements
2025-05-16 ipdmrust: Power on cabin heater only if CabinT > 28.0 or NaN
2025-05-16 ipdmrust: Tweak cabin heater target temperature based on CabinT
2025-05-16 ipdmrust: Tweak cabin heater target temperature based on ignition input
2025-05-16 ipdmrust: Heat battery to 22°C on HvacRequested
2025-05-16 ipdmhw2.0/README.md: Things needed in addition to the factory-populated PCB
2025-05-17 Fix heat loop pump activation conditional
    [lib.rs]
2025-05-17 Additionally charge 12V battery every 4h for 30min if battery is low
2025-05-18 Fix precharge for self-initiated wakeup by powering up OBC/DCDC in time
    [lib.rs]
2025-05-18 Fix precharge for self-initiated wakeup (another issue)
    [lib.rs]
2025-05-18 Fix more self-wakeup issues
    [lib.rs]
2025-05-18 Fix more self-wakeup issues: This oscillation was particularly dumb
    [lib.rs, main.rs]
2025-05-20 ipdmrust: Use theoretically correct Vbat scaling
    [main.rs]
2025-05-20 ipdmrust: Lower last_aux_low_ms threshold from 11.9V to 11.8V
2025-05-21 ipdmrust: Log parameter value changes and allow filtering using console commands
2025-05-21 ipdmrust: Fix Vbat scaling based on real world measurements
    [main.rs]
2025-05-22 ipdmrust: Drop the idle task busywait. For some reason this reduces 12V consumption from 57mA to 37mA
2025-05-22 ipdmrust: Use rtic::export::wfi() in the idle task. This doesn't alter current consumption that much but is probably more correct
    [main.rs]
2025-05-22 ipdmrust: Set cx.core.SCB.set_sleeponexit(). This doesn't currently alter current consumption that much but is probably more correct
    [main.rs]
2025-05-22 ipdmrust: Lower HCLK and SYSCLK from 168 MHz to 84 MHz. This seems to lower 12V consumption from 29mA to 25mA
2025-05-22 ipdmrust: Lower clocks more. This seems to lower 12V consumption from 25mA to 23mA. Note that these numbers are with the CAN controller re-sending a message over and over again as there's nothing els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
2025-05-22 ipdmrust: Correct scaling (3x less than for others) for CurrentL on CANbus
    [lib.rs]
2025-07-28 ipdmrust: README.txt: Explain manual firmware update via UI8D UART bridge
2025-11-14 ipdmrust: README.txt: Rust on stm32 toolchain installation
2025-11-14 ipdmrust: README.txt: Mention stm32flash source
2025-11-14 ipdmrust: README.txt: stm32flash installation
